ajeridi/esp32-iot-car/docs/photos/blynk_dashboard.png

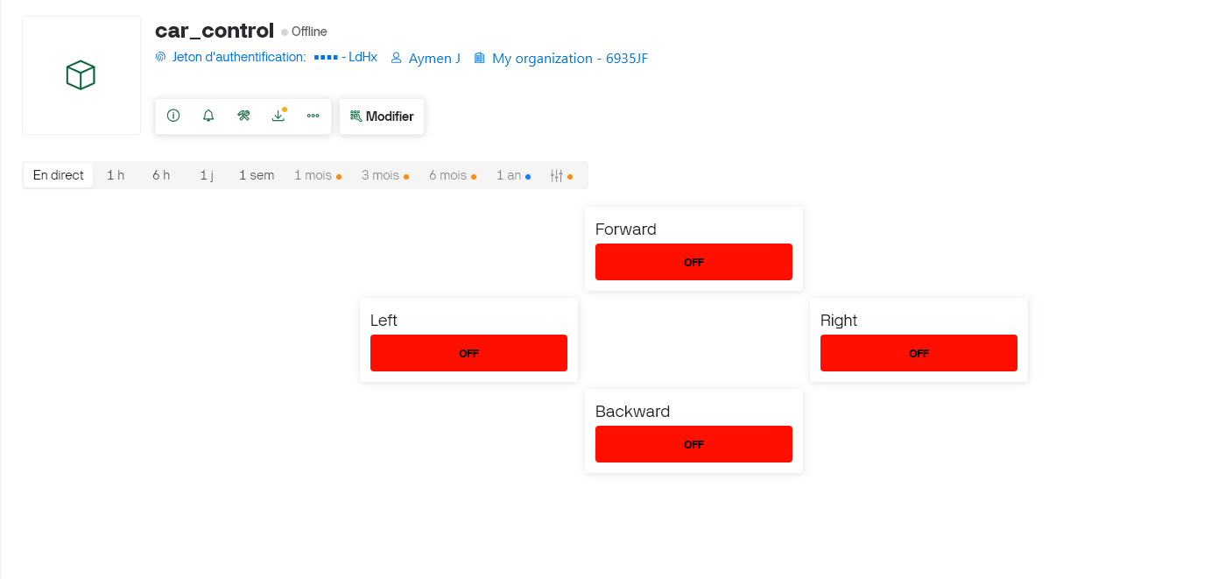
docs/photos/blynk_dashboard.png
