ajeridi/esp32-iot-car/docs/photos/front.jpg

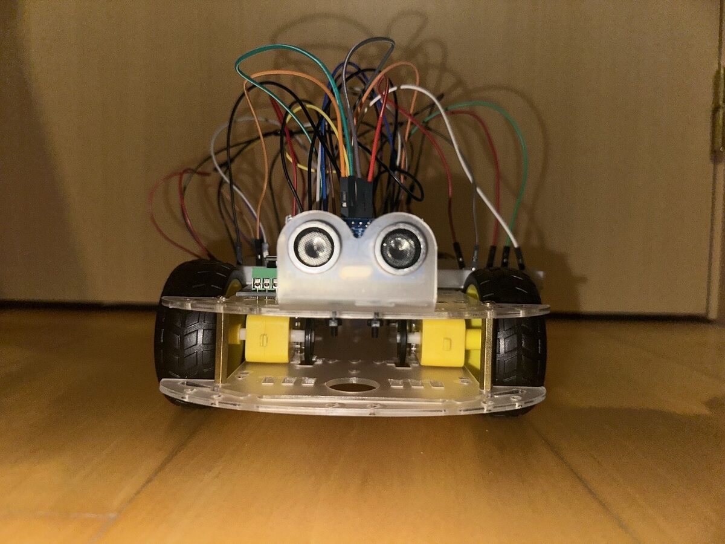
docs/photos/front.jpg
