ajeridi/esp32-iot-car/docs/photos/weather_station.jpg

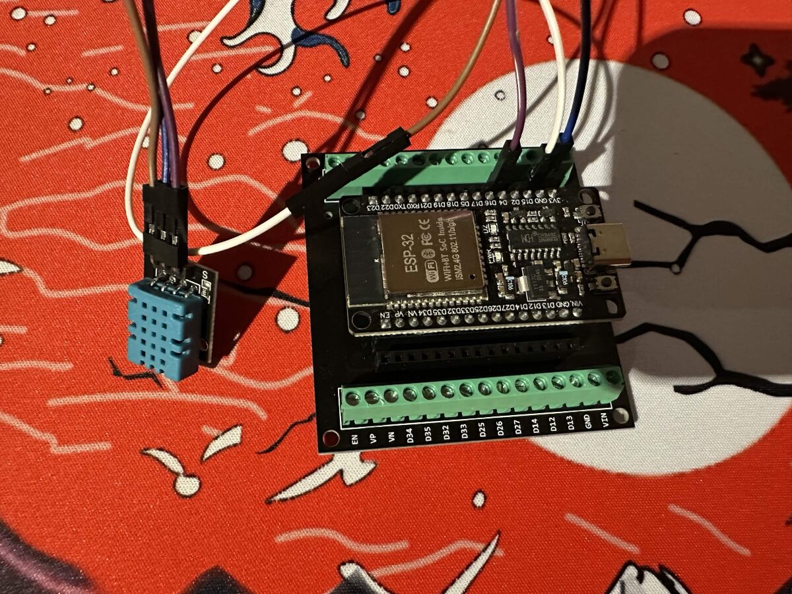
docs/photos/weather_station.jpg
