ajeridi/esp32-iot-car/docs/photos/full_setup.jpg

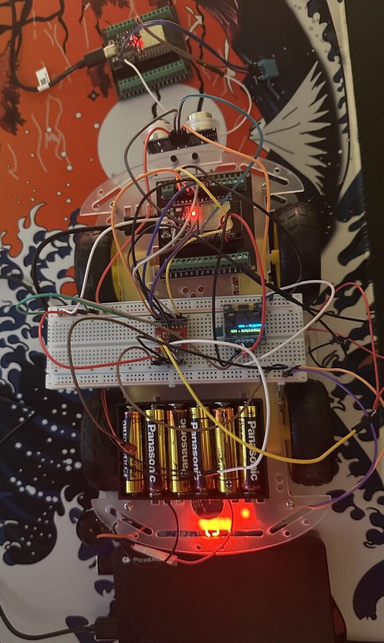
docs/photos/full_setup.jpg
